jasbrothers/jasbrothers.github.io/docs/index.md

# Welcome to Jas Brothers Drones

Jas Bros

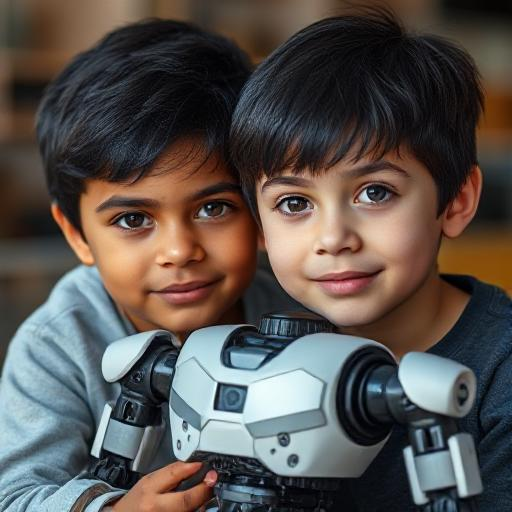
[picture p1: docs/images/jasbrothers.jpeg]
Jas Brothers


## About Us

We are two brothers learning about the world by building advanced robots.

## Writing

- [Level 2 Programming](blog/level-2-programming.md) — a six-year-old drew a
  smart speaker on a sheet of paper. It turns out Level 2 is a high enough
  reading level to build one.
- [What a Smart Speaker Actually Costs](blog/what-a-smart-speaker-costs.md) —
  every part, every price, and the arithmetic that turns $113.00 of components
  into a shelf price.
