jasbrothers/jasbrothers.github.io/docs/images/robotbros.jpeg

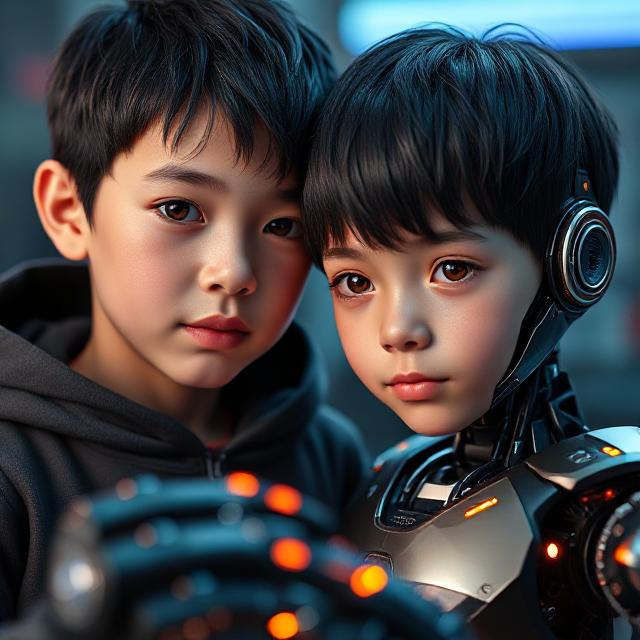
docs/images/robotbros.jpeg
