jasbrothers/jasbrothers.github.io/docs/blog/files/smart-speaker-bom.xlsx

Sheet: BOM
Smart Speaker - Bill of Materials (Raspberry Pi 4 + reSpeaker hardware-DSP mic array)
Kit configuration, qty = 1 (prototype pricing). Yellow = input, orange = board selector, green = formula.
Category | Component | Notes / Part Spec | Qty per Unit | Unit Cost ($) | Ext. Cost ($)
Compute | Raspberry Pi 4 Model B (2GB) | 2GB fits whisper.cpp base.en + OS; 4GB is the fallback if it doesn't | 1 | 45.00
Compute | microSD card 16GB (A1 rated) | OS + model weights | 1 | 5.50
Compute | USB-C PSU (5V/3A) | Quality supply; brownouts show up as audio dropouts | 1 | 6.00
Compute | Passive heatsink set | No fan: a fan is a microphone's worst enemy | 1 | 2.00
Audio Capture |  | Hardware AEC is the non-negotiable part. Cost driven by the selector. | 1
Audio Capture | USB-C cable (short) | Mic array to Pi; array is USB Audio Class 2.0 | 1 | 3.50
Audio Output | 5W full-range speaker driver, 4 ohm | Driven directly from the array board's JST speaker connector | 1 | 7.00
Audio Output | JST-PH 2-pin speaker pigtail | Board-to-driver, pre-terminated | 1 | 0.75
Cables & Connectors | Board mounting hardware | Standoffs for the array board; it is USB, not a HAT | 1 | 2.00
Cables & Connectors | Internal wiring kit (misc. jumpers) | Power/ground routing | 1 | 1.50
Enclosure | 3D-printed enclosure shell | Acoustic ports for mics + speaker grille; printed at qty 1 | 1 | 9.00
Enclosure | Acoustic damping foam | Reduces internal cavity resonance | 1 | 2.00
Enclosure | M2.5 screws/fasteners set | Board + enclosure assembly | 1 | 1.00
Packaging & Misc | Kit box + foam insert | Ships as parts; no retail branding | 1 | 2.50
Packaging & Misc | Quick-start card (QR to docs) | Manual lives on the web and stays current | 1 | 0.35
TOTAL BOM / UNIT
MIC ARRAY OPTIONS | Selected board >> | Lite | <- type Lite / XVF3800 / v2.0 / HAT
Key | Board | Price ($) | Hardware DSP | Notes
Lite | reSpeaker Lite (XMOS XU316) | 24.90 | AEC, interference cancellation, noise suppression, AGC. No beamforming. | 2 mics, 3m far-field. USB UAC2. JST 5W speaker out + 3.5mm. Cheapest board that keeps hardware AEC.
XVF3800 | reSpeaker XVF3800, no XIAO | 54.00 | AEC, multi-beamforming, de-reverberation, DoA, noise suppression, 60dB AGC. | 4 mics, 5m far-field. USB-C UAC2. JST 5W speaker out. 12x WS2812 RGB ring + hardware mute button. Street price seen 49.99-60.99 - get a quote.
v2.0 | reSpeaker Mic Array v2.0 (XVF3000) | 64.00 | AEC, beamforming, DoA, noise suppression. | 4 mics, 5m. Superseded by XVF3800 - listed for reference, do not buy.
HAT | reSpeaker 4-Mic Array HAT (AC108) | 24.90 | NONE - it is a codec, not a DSP. | 4 mics + 12 RGB LEDs, but all AEC/beamforming falls back to software on the Pi. No audio out. A trap for this build.
Note: single-unit / low-volume estimates (Aug 2026) from Seeed and typical distributors. Volume at 1k+ typically runs 25-40% lower, especially the Pi. Excludes FCC/CE certification, tooling, and our own time.

Sheet: Pricing
Pricing & Margin Model
Yellow = input, green = formula. Target margin drives the computed price; set the shelf price yourself and check the result.
COST INPUTS
BOM cost per unit (from BOM sheet) |  | Live link. Changes when you switch the mic array selector.
Pick & pack labor - kit | 8.00 | Counting parts into a box
Assembly labor - assembled unit | 25.00 | Build, flash, bench-test, burn-in
Enclosure + retail packaging upgrade | 9.00 | Assembled units get a finished shell and retail box
COGS
COGS - kit |  | What one kit costs us to put in a box
COGS - assembled |  | BOM + upgrade + assembly + pick/pack
TARGET GROSS MARGIN
Target gross margin | 50.0% | The number we are solving for
Computed price - kit |  | COGS / (1 - margin)
Computed price - assembled |  | COGS / (1 - margin)
SHELF PRICE (set by hand, then check the margin)
Shelf price - kit | 249.00 | Rounded up from the computed price
Shelf price - assembled | 319.00 | Rounded up from the computed price
Shelf price - early bird kit | 219.00 | Launch-day tier, deliberately thinner
Achieved gross margin - kit |  | Must land at or above target
Achieved gross margin - assembled |  | Must land at or above target
Achieved gross margin - early bird |  | Thinner on purpose
WHAT GROSS MARGIN DOES NOT COVER
Platform + payment fees | 8.5% | Kickstarter 5% + payment processing ~3.5%
Failure / replacement / support reserve | 5.0% | Dead-on-arrival units, reships, our support time
Shipping to backer | 0.00 | Collected separately at pledge time - pass-through, not margin
CONTRIBUTION PER UNIT (the number that says we survive)
Contribution - kit |  | Gross profit less fees, reserve, shipping
Contribution % - kit
Contribution - assembled
Contribution % - assembled
Contribution - early bird kit
Contribution % - early bird kit
CAMPAIGN BREAK-EVEN
Fixed costs to fund | 12000.00 | Tooling, first parts buy, test gear, photography. Excludes FCC/CE.
Assumed mix - share sold as kits | 70.0% | Kits are easier to ship and likelier to sell
Blended contribution per unit |  | Weighted by the mix above
Units to break even |  | Fixed costs / blended contribution
Pledge revenue at break-even |  | The funding goal, roughly
