jasbrothers/jasbrothers.github.io/docs/blog/files/smart-speaker-base-plate.stl

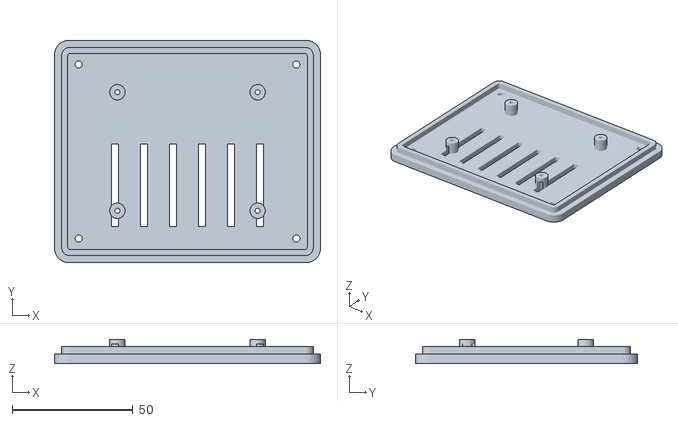
[picture p5: CAD file, 2026-08-23]
docs/blog/files/smart-speaker-base-plate.stl
110.0 x 92.0 x 10.0
