jasbrothers/jasbrothers.github.io/docs/blog/files/smart-speaker-body-shell.stl

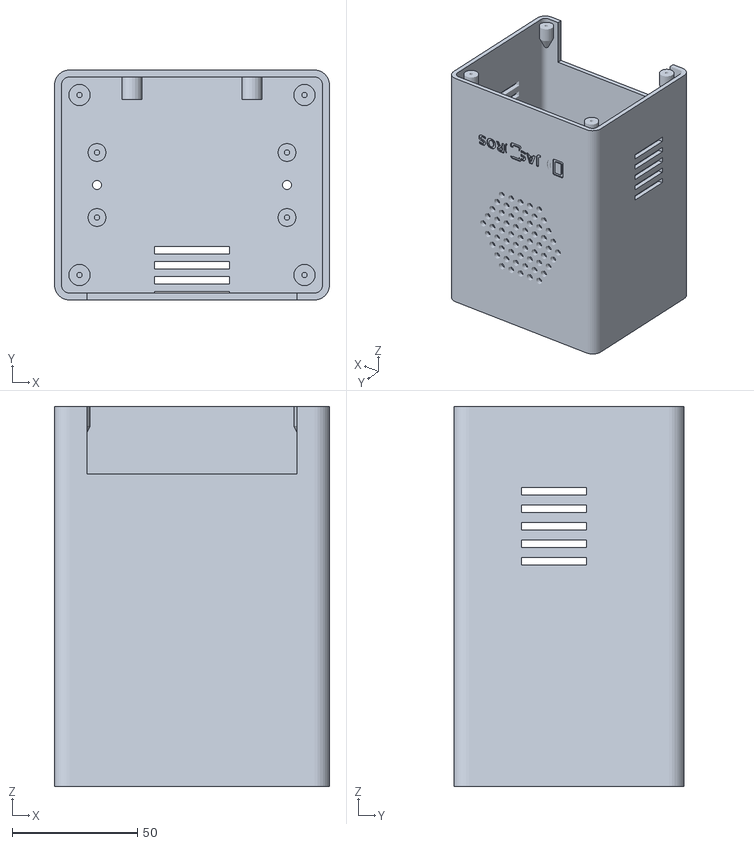
[picture p6: CAD file, 2026-08-23]
docs/blog/files/smart-speaker-body-shell.stl
110.0 x 92.0 x 152.0
