jasbrothers/jasbrothers.github.io/docs/blog/files/smart-speaker-enclosure.3mf

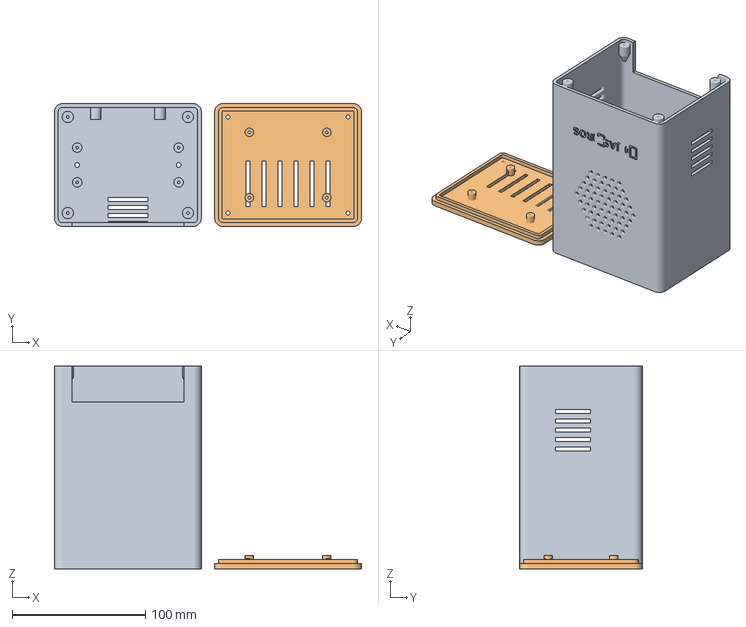
[picture p7: CAD file, 2026-08-23]
docs/blog/files/smart-speaker-enclosure.3mf
230.0 x 92.0 x 152.0 mm
body_shell
base_plate
