jasbrothers/jasbrothers.github.io/(commit log)

2026-08-23 Add "What a Smart Speaker Actually Costs" with the open BOM
    Publishes the full bill of materials and the pricing model behind it,
    ahead of a Kickstarter campaign.
    The BOM is rebuilt around a hardware-DSP microphone array kept for its
    acoustic echo cancellation, which the box needs in order to be
    interrupted while it is talking. Pricing the alternatives turned up an
    error in the original sheet: the "4-Mic Circular Array (XMOS) $69.99"
    line named the AC108 HAT ($24.90, no DSP) at the price of the Mic Array
    v2.0 ($64.00). Both are superseded by the XVF3800. Selected the
    reSpeaker Lite at $24.90, which keeps hardware AEC and includes a 5W
    speaker output, deleting the separate DAC/amp line.
    BOM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
    [smart-speaker-bom.csv, smart-speaker-bom.xlsx]
2026-08-23 Add the enclosure model, print files, and the Jas Bros brand mark
    Models the speaker so the bill of materials has a box to live in.
    The enclosure is parametric solid geometry: a 110 x 92 x 152 mm body
    shell and a base plate, both watertight, exported as a print-oriented
    3MF (plus STLs) that lays out at 230 x 92 mm on a Bambu P1S bed.
    Roughly 225 g and 51 g of filament.
    Three features exist for printability rather than looks. The shell
    prints top-face-down, because printed upright its top face would have
    to bridge the whole 104 x 86 mm cavity. The rear I/O opening runs off
    the bottom edge as a notch, so inverted it bridges nothing and the base
    plate seals it anyway. The grille is sixty-one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
    [smart-speaker-base-plate.stl, smart-speaker-body-shell.stl, smart-speaker-enclosure.3mf]
2026-08-23 Cut the version history from the BOM post
    The post spent three sections explaining what an earlier bill of
    materials got wrong. Readers want the speaker that exists, not the one
    that didn't.
    Removes the "$207.99 first version" section and the "mistake" subsection
    about a mis-specified microphone array line. Rewrites the cut-by-cut
    comparison as decisions in their own right: why a 2GB Pi, why one
    driver, why no fan. The microphone array is now argued from acoustic
    echo cancellation rather than from what it replaced.
    The board comparison table stays -- that is a live decision, not history
    -- as does the note that the far-field call is unproven.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
2026-08-23 Rewrite the BOM post in plainer prose
    The post read like a machine wrote it. No contractions anywhere, every
    section built on the same bold-lead-in-then-em-dash template, and the
    "it isn't X, it's Y" construction four separate times.
    Loosens the voice: contractions throughout, shorter sentences, varied
    paragraph shapes, and roughly a third fewer em dashes. Cuts about 300
    words of prose, mostly restatement. Drops the stray British spellings
    (labour, metres, catalogue) that had crept in.
    Every number is unchanged and re-verified: the parts table still sums to
    $113.00, margins hold at 51.4 / 51.4 / 44.7 percent, and contribution is
    still $94.38 a kit.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
2026-08-23 Add a "Hey Claude" speech bubble to the product shot
    Puts the wake word back in the picture, the way it appeared in the
    drawing this project started from: someone says it to the box.
    The bubble's tail is anchored to the real projected position of the
    left microphone port rather than to fixed screen coordinates, so it
    keeps pointing at the right spot if the case dimensions change.
    Also fixes the transparent view's aria-label, which had picked up the
    product shot's description and claimed a speech bubble it does not have.
    Claude-Session: https://claude.ai/code/session_01LDQJHXacP2LWvG3Wrdrsz4
2026-08-23 Make the wake word come from a person, not the speaker
    A speech bubble hanging off the box reads as the box talking, whichever
    way the tail points. But nobody says "Hey Claude" to summon themselves --
    the user says it, and the speaker listens.
    Replaces the bubble with the composition from the drawing this project
    started with: a stick figure on the left says the wake word, sound
    travels across to the box. The figure is placed against the speaker's
    projected bounds rather than fixed coordinates, so it holds its position
    if the case dimensions change.
    Illustration only. No change to the enclosure, the 3MF or the STLs.
    Claude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
